garrettsworkshop/MacVRAMSIMM/256kB-2chip-SOJ/Documentation/FrontIsom.png

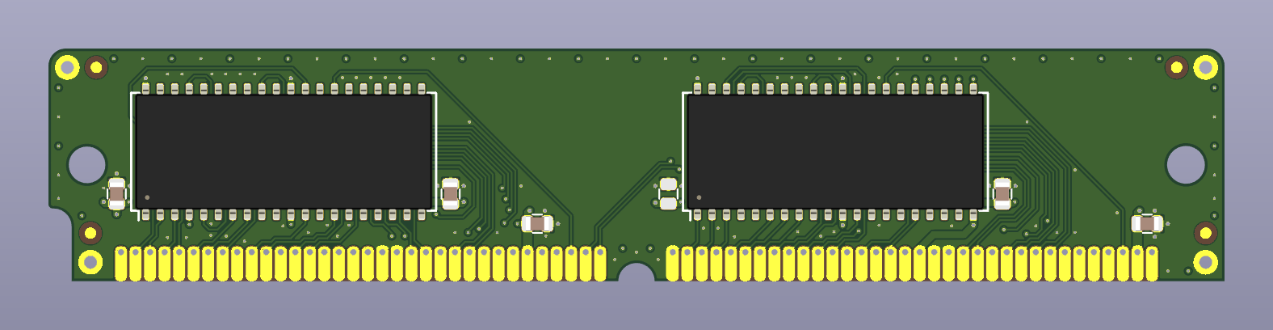
256kB-2chip-SOJ/Documentation/FrontIsom.png
