garrettsworkshop/MacVRAMSIMM/256kB-2chip-SOJ/Documentation/BackIsom.png

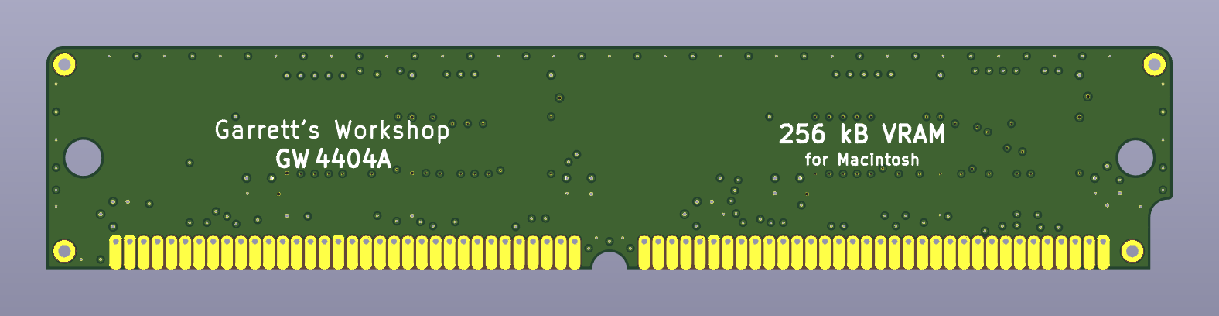
256kB-2chip-SOJ/Documentation/BackIsom.png
