garrettsworkshop/MacVRAMSIMM/256kB-2chip-SOJ/Documentation/VRAM 256 Inner Layer.png

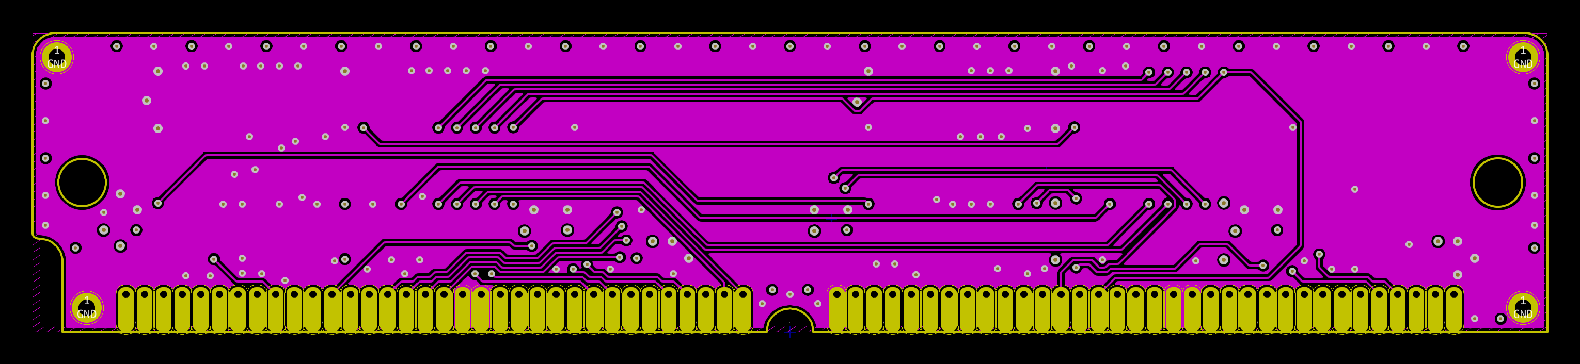
256kB-2chip-SOJ/Documentation/VRAM 256 Inner Layer.png
