garrettsworkshop/MacVRAMSIMM/256kB-2chip-SOJ/Documentation/VRAM 256 Top Layer.png

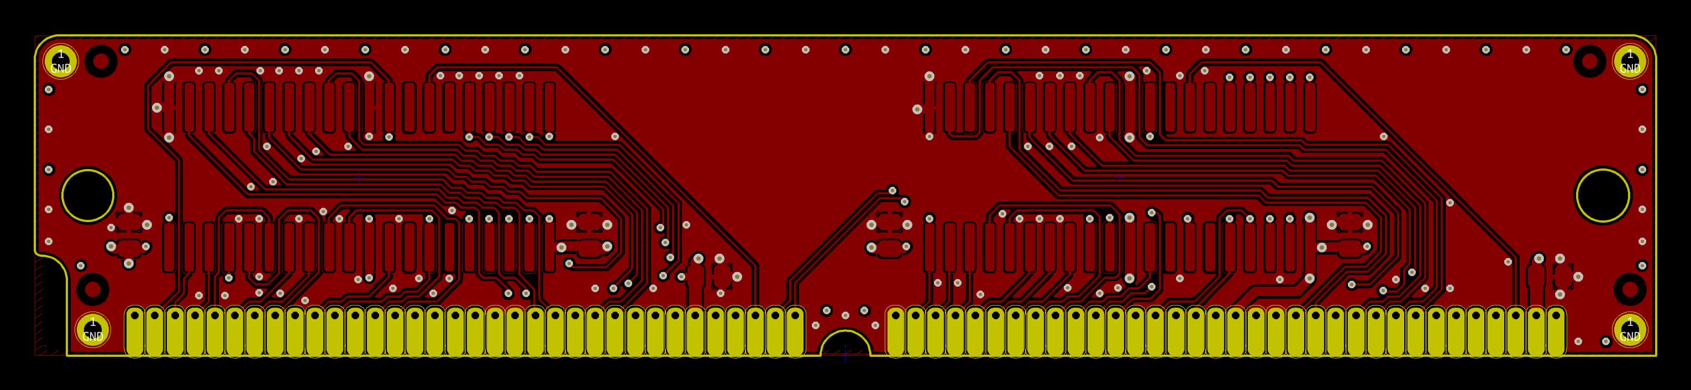
256kB-2chip-SOJ/Documentation/VRAM 256 Top Layer.png
