garrettsworkshop/MacVRAMSIMM/512kB-2chip-SOJ/Documentation/VRAM 512 Inner Layer.png

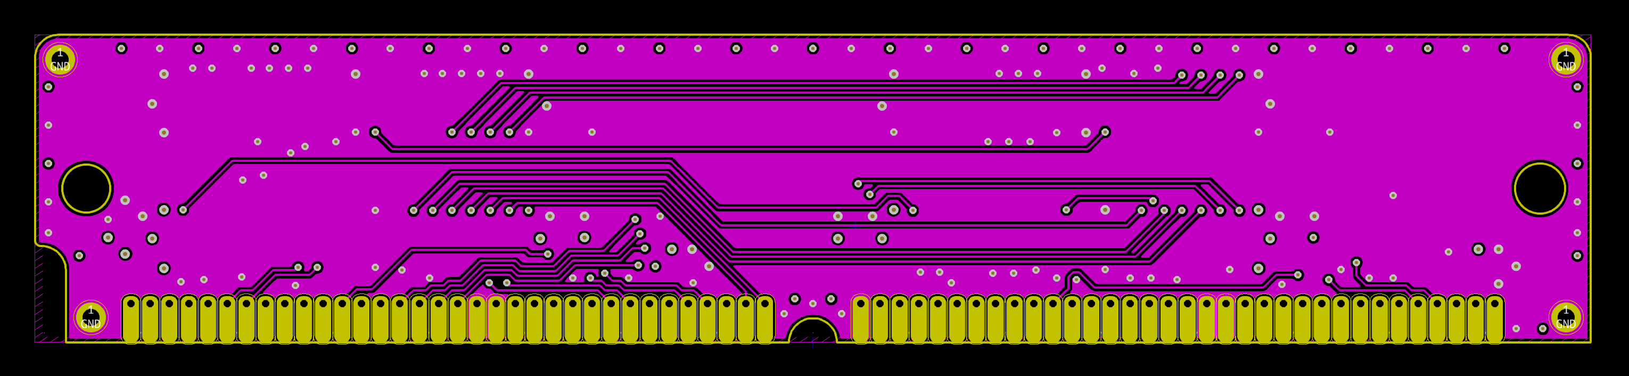
512kB-2chip-SOJ/Documentation/VRAM 512 Inner Layer.png
