garrettsworkshop/MacVRAMSIMM/256kB-2chip-SOJ/Documentation/Schematic.pdf

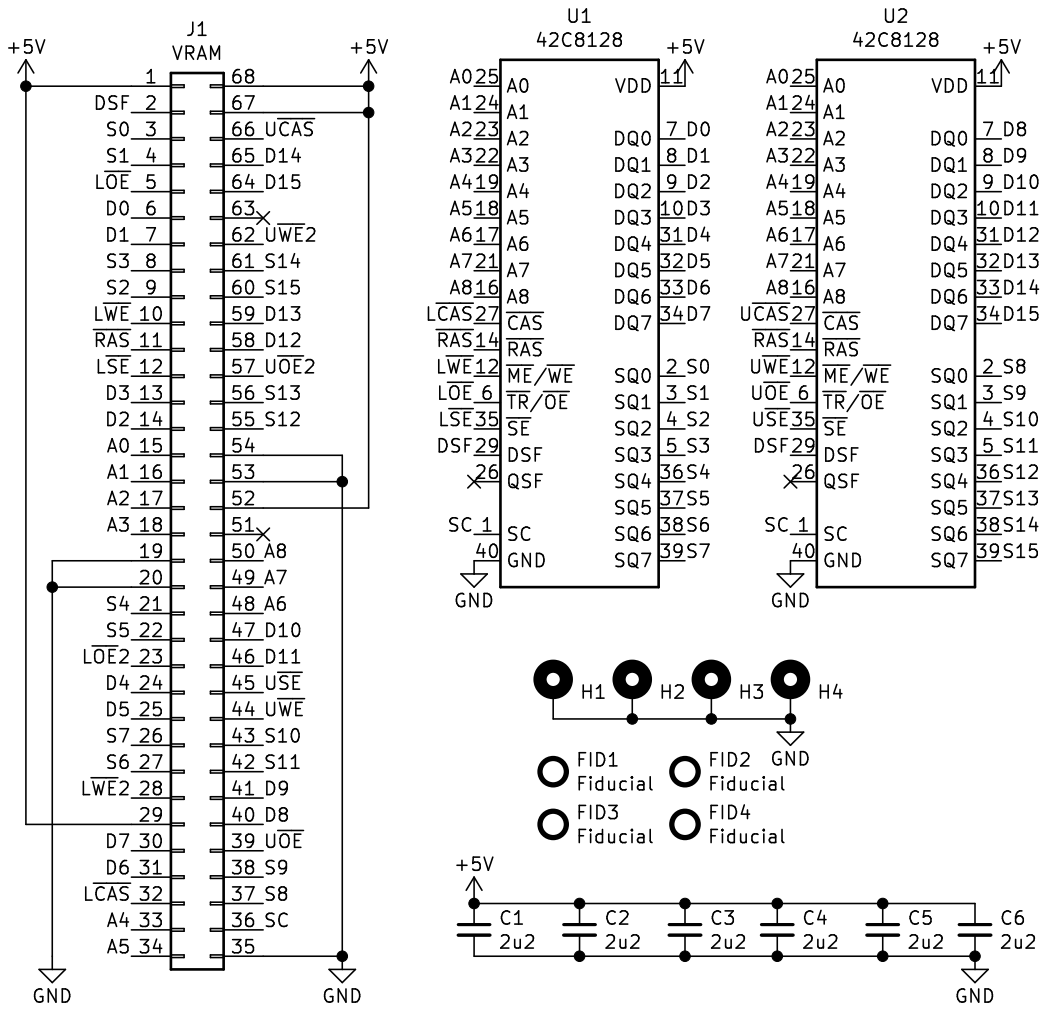
[picture p7: page 1]
