garrettsworkshop/MacVRAMSIMM/512kB-2chip-SOJ/Documentation/Schematic.pdf

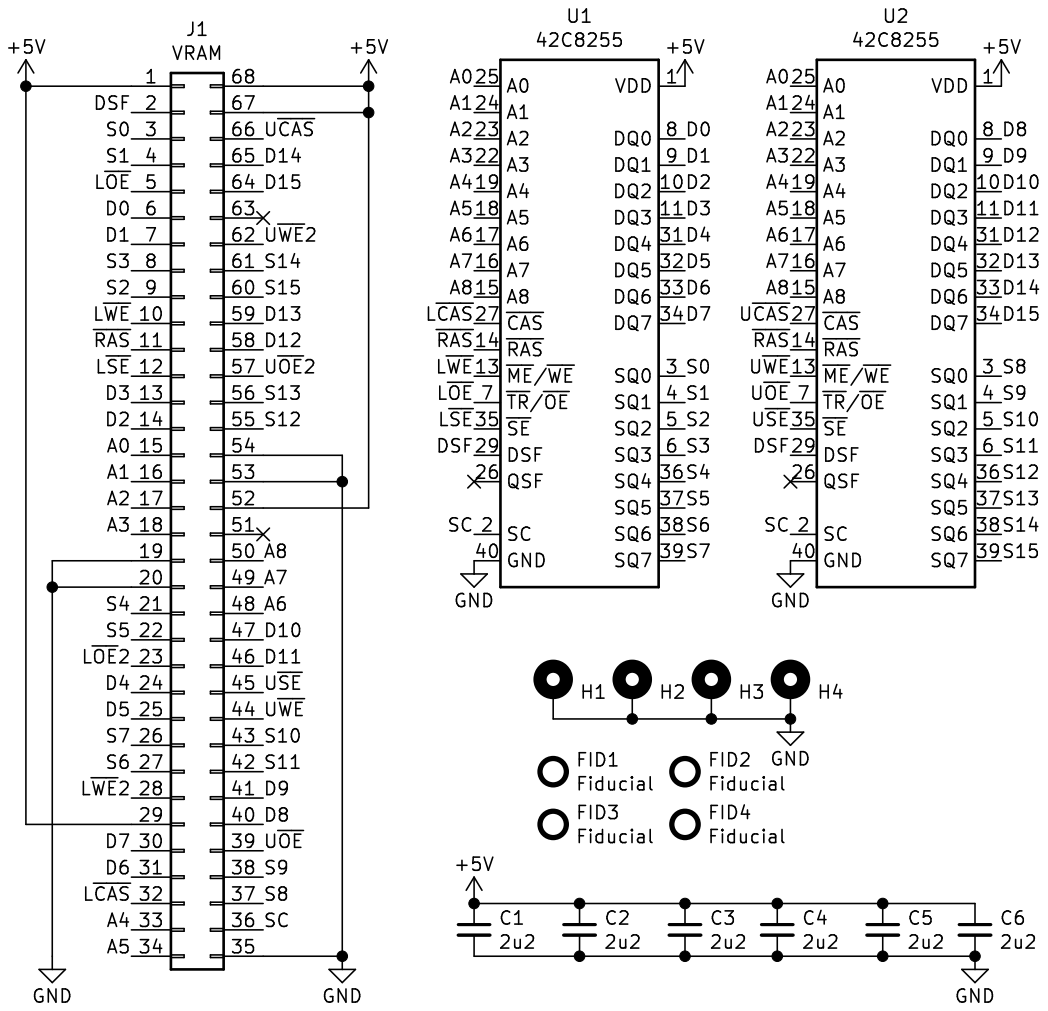
[picture p8: page 1]
