garrettsworkshop/MacVRAMSIMM/256kB-2chip-SOJ/Documentation/Placement.pdf

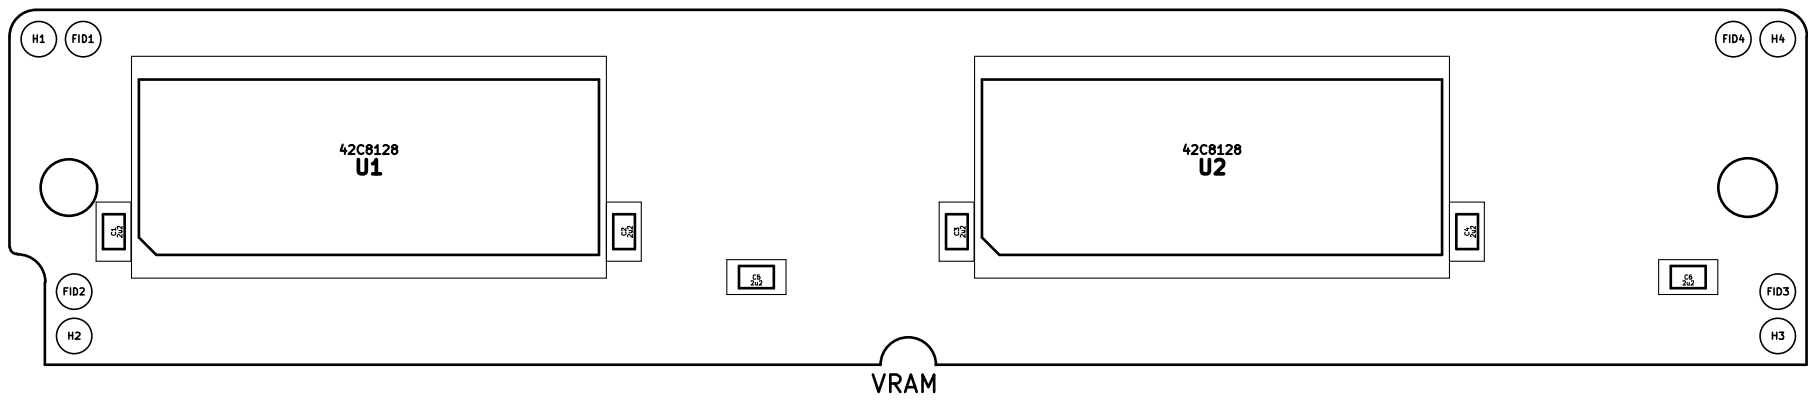
[picture p9: page 1]
