garrettsworkshop/MacVRAMSIMM/512kB-2chip-SOJ/Documentation/Placement.pdf

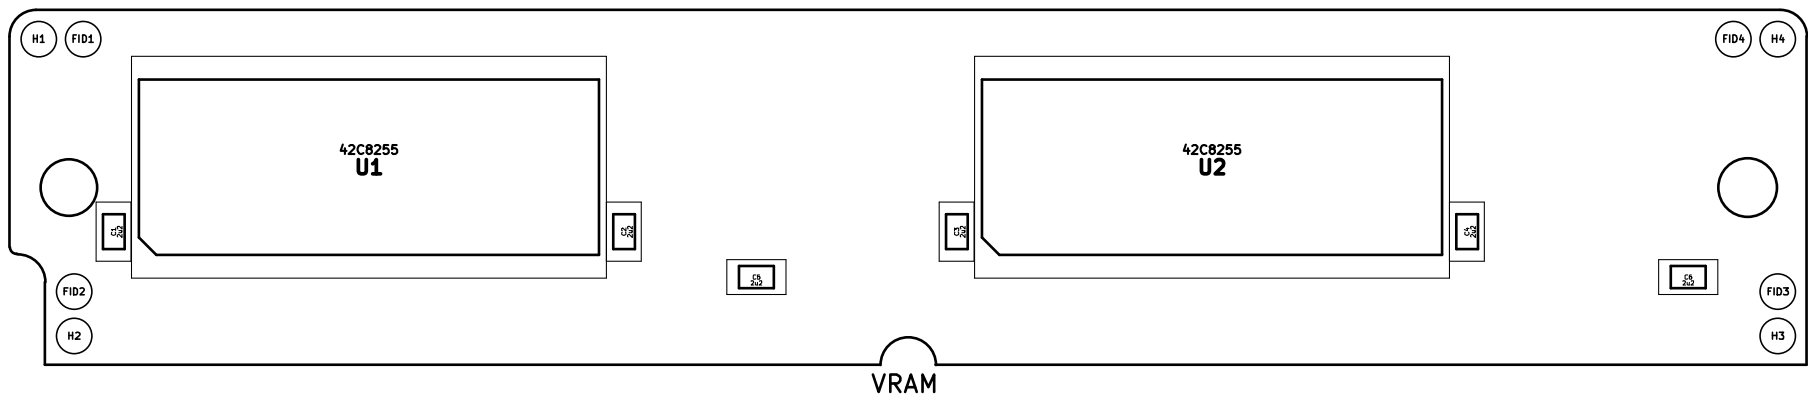
[picture p10: page 1]
