garrettsworkshop/MacVRAMSIMM/512kB-2chip-SOJ/MacVRAMSIMM.kicad_pcb

## KiCad design 512kB-2chip-SOJ/MacVRAMSIMM.kicad_pcb (2022-02-06)

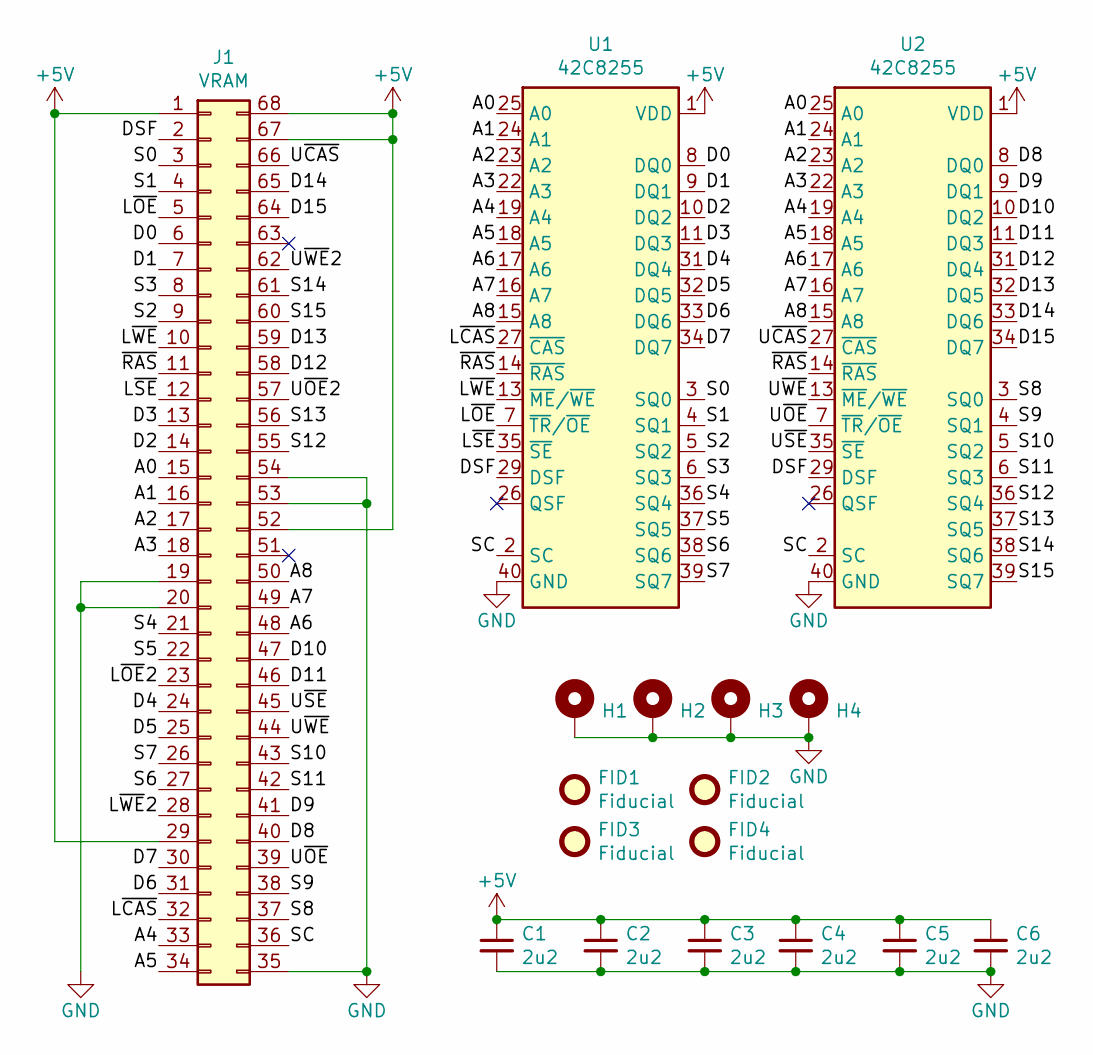
[picture p11: schematic MacVRAMSIMM.kicad_sch, GW4405A]

Parts:
C1, C2, C3, C4, C5, C6: 2u2; C_0805
FID1, FID2, FID3, FID4: Fiducial
H1, H2, H3, H4: PasteHole_1.1mm_PTH
J1: VRAM; MacVRAMSIMM_Edge
U1, U2: 42C8255; SOJ-40_400mil

Connections:
+5V: C1.1, C2.1, C3.1, C4.1, C5.1, C6.1, J1.1, J1.29, J1.52, J1.67, J1.68, U1.1 (VDD), U1.20 (VDD), U2.1 (VDD), U2.20 (VDD)
/A0: J1.15, U1.25 (A0), U2.25 (A0)
/A1: J1.16, U1.24 (A1), U2.24 (A1)
/A2: J1.17, U1.23 (A2), U2.23 (A2)
/A3: J1.18, U1.22 (A3), U2.22 (A3)
/A4: J1.33, U1.19 (A4), U2.19 (A4)
/A5: J1.34, U1.18 (A5), U2.18 (A5)
/A6: J1.48, U1.17 (A6), U2.17 (A6)
/A7: J1.49, U1.16 (A7), U2.16 (A7)
/A8: J1.50, U1.15 (A8), U2.15 (A8)
/D0: J1.6, U1.8 (DQ0)
/D1: J1.7, U1.9 (DQ1)
/D2: J1.14, U1.10 (DQ2)
/D3: J1.13, U1.11 (DQ3)
/D4: J1.24, U1.31 (DQ4)
/D5: J1.25, U1.32 (DQ5)
/D6: J1.31, U1.33 (DQ6)
/D7: J1.30, U1.34 (DQ7)
/D8: J1.40, U2.8 (DQ0)
/D9: J1.41, U2.9 (DQ1)
/D10: J1.47, U2.10 (DQ2)
/D11: J1.46, U2.11 (DQ3)
/D12: J1.58, U2.31 (DQ4)
/D13: J1.59, U2.32 (DQ5)
/D14: J1.65, U2.33 (DQ6)
/D15: J1.64, U2.34 (DQ7)
/DSF: J1.2, U1.29 (DSF), U2.29 (DSF)
/L~CAS: J1.32, U1.27 (~CAS)
/L~OE: J1.5, U1.7 (~TR/~OE)
/L~OE2: J1.23
/L~SE: J1.12, U1.35 (~SE)
/L~WE: J1.10, U1.13 (~ME/~WE)
/L~WE2: J1.28
/S0: J1.3, U1.3 (SQ0)
/S1: J1.4, U1.4 (SQ1)
/S2: J1.9, U1.5 (SQ2)
/S3: J1.8, U1.6 (SQ3)
/S4: J1.21, U1.36 (SQ4)
/S5: J1.22, U1.37 (SQ5)
/S6: J1.27, U1.38 (SQ6)
/S7: J1.26, U1.39 (SQ7)
/S8: J1.37, U2.3 (SQ0)
/S9: J1.38, U2.4 (SQ1)
/S10: J1.43, U2.5 (SQ2)
/S11: J1.42, U2.6 (SQ3)
/S12: J1.55, U2.36 (SQ4)
/S13: J1.56, U2.37 (SQ5)
/S14: J1.61, U2.38 (SQ6)
/S15: J1.60, U2.39 (SQ7)
/SC: J1.36, U1.2 (SC), U2.2 (SC)
/U~CAS: J1.66, U2.27 (~CAS)
/U~OE: J1.39, U2.7 (~TR/~OE)
/U~OE2: J1.57
/U~SE: J1.45, U2.35 (~SE)
/U~WE: J1.44, U2.13 (~ME/~WE)
/U~WE2: J1.62
/~RAS: J1.11, U1.14 (~RAS), U2.14 (~RAS)
GND: C1.2, C2.2, C3.2, C4.2, C5.2, C6.2, H1.1, H2.1, H3.1, H4.1, J1.19, J1.20, J1.35, J1.53, J1.54, U1.12 (GND), U1.21 (GND), U1.30 (GND), U1.40 (GND), U2.12 (GND), U2.21 (GND), U2.30 (GND), U2.40 (GND)

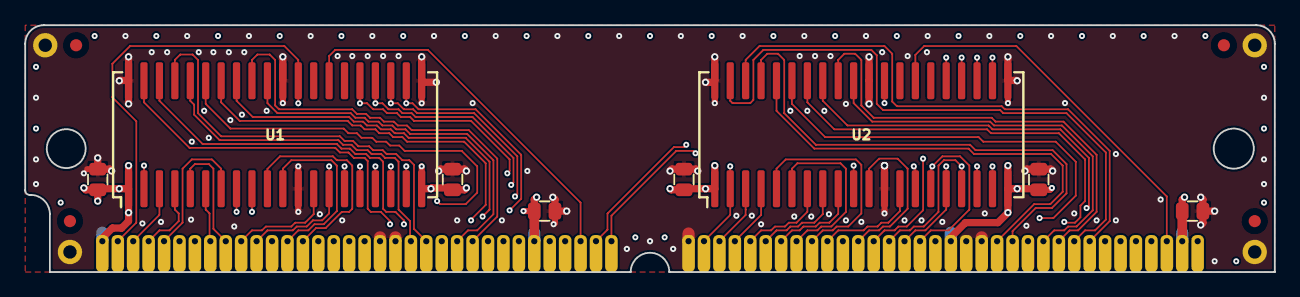
[picture p12: board MacVRAMSIMM.kicad_pcb from above]

Board: 4 copper layers, 102.9 x 20.3 mm, 17 parts (0 on the bottom side), 54 nets.
