garrettsworkshop/MacVRAMSIMM/(commit log)

2022-02-06 Migrate to KiCAD 6
    [MacVRAMSIMM.kicad_pcb, MacVRAMSIMM.kicad_sch, MacVRAMSIMM.sch]
2022-02-06 Switch to KiCAD 6 3dmodels
    [MacVRAMSIMM.kicad_pcb]
